MohamedReda2003/ENV-SENSE-DONGLE/ENV-SENSE-DONGLE.kicad_pcb

## KiCad design ENV-SENSE-DONGLE.kicad_pcb (2026-11-01)

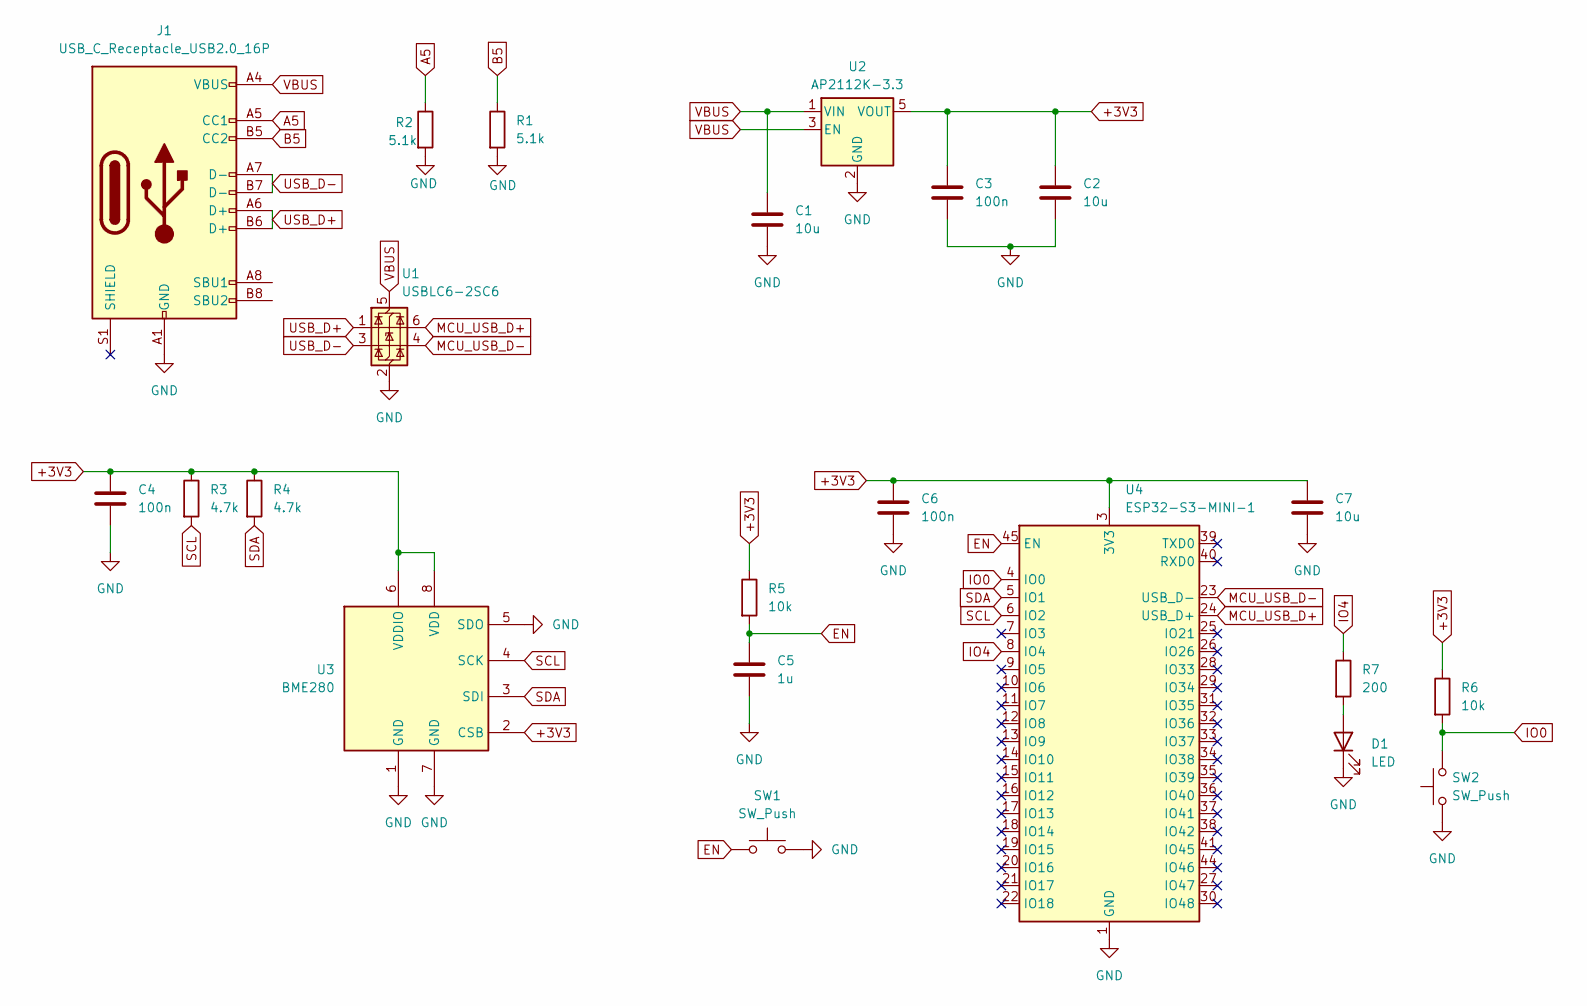
[picture p5: schematic ENV-SENSE-DONGLE.kicad_sch]

Parts:
C1, C2, C7: 10u; CP_Axial_L10.0mm_D4.5mm_P15.00mm_Horizontal
C3, C4, C6: 100n; CP_Axial_L10.0mm_D4.5mm_P15.00mm_Horizontal
C5: 1u; CP_Axial_L10.0mm_D4.5mm_P15.00mm_Horizontal
D1: LED; LED_D1.8mm_W1.8mm_H2.4mm_Horizontal_O3.81mm_Z4.9mm
J1: USB_C_Receptacle_USB2.0_16P; USB_C_Receptacle_HRO_TYPE-C-31-M-12
R1, R2: 5.1k; R_Axial_DIN0204_L3.6mm_D1.6mm_P2.54mm_Vertical
R3, R4: 4.7k; R_Axial_DIN0204_L3.6mm_D1.6mm_P2.54mm_Vertical
R5, R6: 10k; R_Axial_DIN0204_L3.6mm_D1.6mm_P2.54mm_Vertical
R7: 200; R_Axial_DIN0204_L3.6mm_D1.6mm_P2.54mm_Vertical
SW1, SW2: SW_Push; SW_PUSH_6mm
U1: USBLC6-2SC6; SOT-23-6
U2: AP2112K-3.3; SOT-23-5
U3: BME280; Bosch_LGA-8_2.5x2.5mm_P0.65mm_ClockwisePinNumbering
U4: ESP32-S3-MINI-1; ESP32-S2-MINI-1

Connections:
+3V3: C2.1, C3.1, C4.1, C6.1, C7.1, R3.1, R4.1, R5.1, R6.1, U2.5 (VOUT), U3.2 (CSB), U3.6 (VDDIO), U3.8 (VDD), U4.3 (3V3)
A5: J1.A5 (CC1), R2.1
B5: J1.B5 (CC2), R1.1
EN: C5.1, R5.2, SW1.1, U4.45 (EN)
GND: C1.2, C2.2, C3.2, C4.2, C5.2, C6.2, C7.2, D1.1 (K), J1.A1 (GND), J1.A12 (GND), J1.B1 (GND), J1.B12 (GND), R1.2, R2.2, SW1.2, SW2.1, U1.2 (GND), U2.2 (GND), U3.1 (GND), U3.5 (SDO), U3.7 (GND), U4.1 (GND), U4.2 (GND), U4.42 (GND), U4.43 (GND), U4.46 (GND), U4.47 (GND), U4.48 (GND), U4.49 (GND), U4.50 (GND), U4.51 (GND), U4.52 (GND), U4.53 (GND), U4.54 (GND), U4.55 (GND), U4.56 (GND), U4.57 (GND), U4.58 (GND), U4.59 (GND), U4.60 (GND), U4.61 (GND), U4.62 (GND), U4.63 (GND), U4.64 (GND), U4.65 (GND)
IO0: R6.2, SW2.2, U4.4 (IO0)
IO4: R7.1, U4.8 (IO4)
MCU_USB_D+: U1.6 (I/O1), U4.24 (USB_D+)
MCU_USB_D-: U1.4 (I/O2), U4.23 (USB_D-)
unnamed: D1.2 (A), R7.2
SCL: R3.2, U3.4 (SCK), U4.6 (IO2)
SDA: R4.2, U3.3 (SDI), U4.5 (IO1)
USB_D+: J1.A6 (D+), J1.B6 (D+), U1.1 (I/O1)
USB_D-: J1.A7 (D-), J1.B7 (D-), U1.3 (I/O2)
VBUS: C1.1, J1.A4 (VBUS), J1.A9 (VBUS), J1.B4 (VBUS), J1.B9 (VBUS), U1.5 (VBUS), U2.1 (VIN), U2.3 (EN)

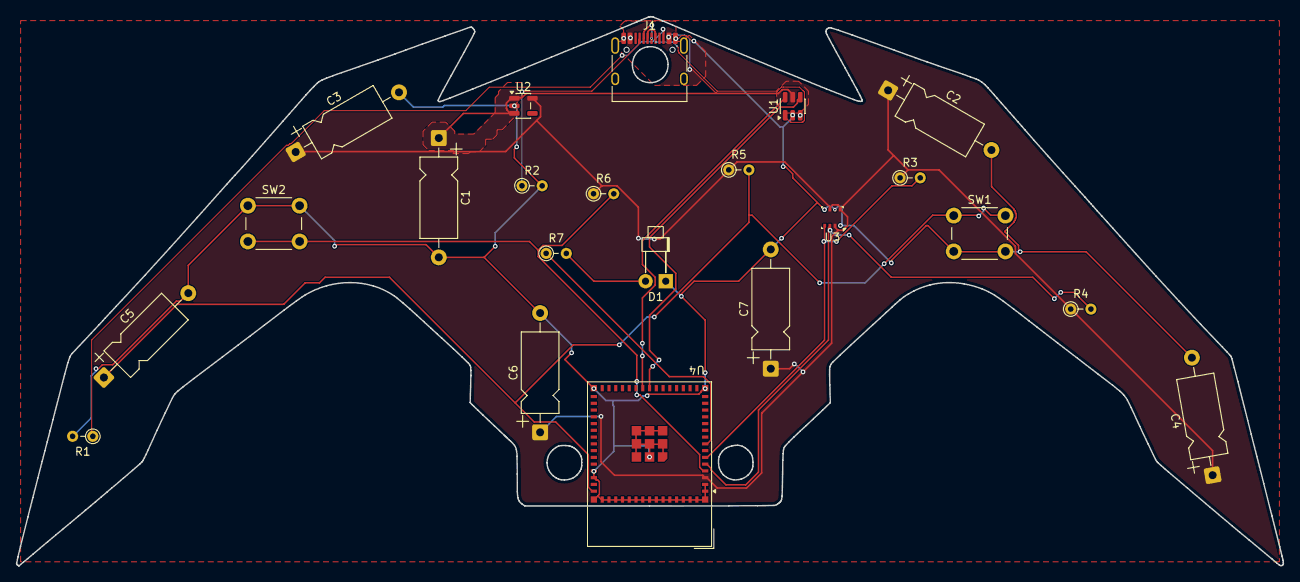
[picture p6: board ENV-SENSE-DONGLE.kicad_pcb from above]

Board: 2 copper layers, 159.3 x 69.0 mm, 22 parts (0 on the bottom side), 15 nets.
